Yarzou/porte-magique/docs/notice/img/e-accouplement.png

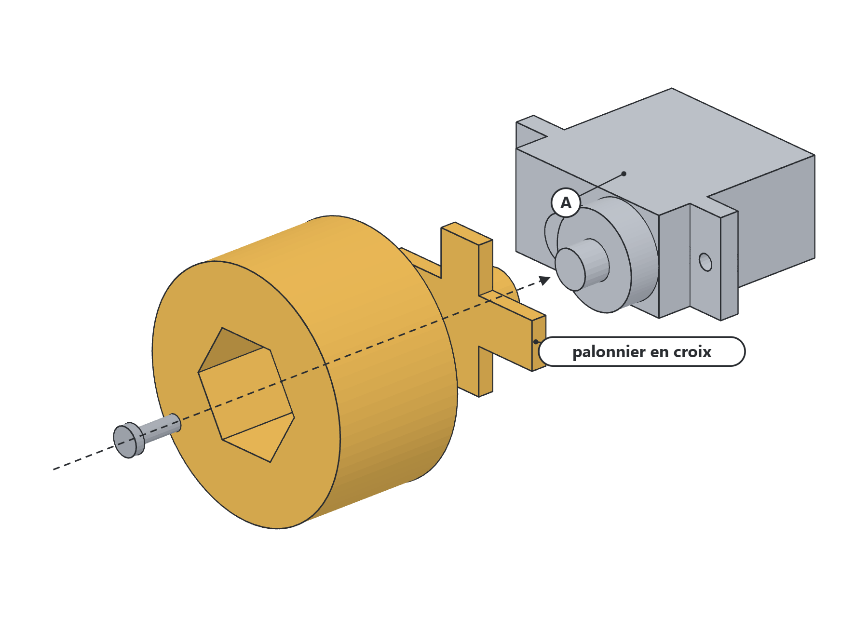
docs/notice/img/e-accouplement.png
