Yarzou/porte-magique/docs/notice/img/e-carte.png

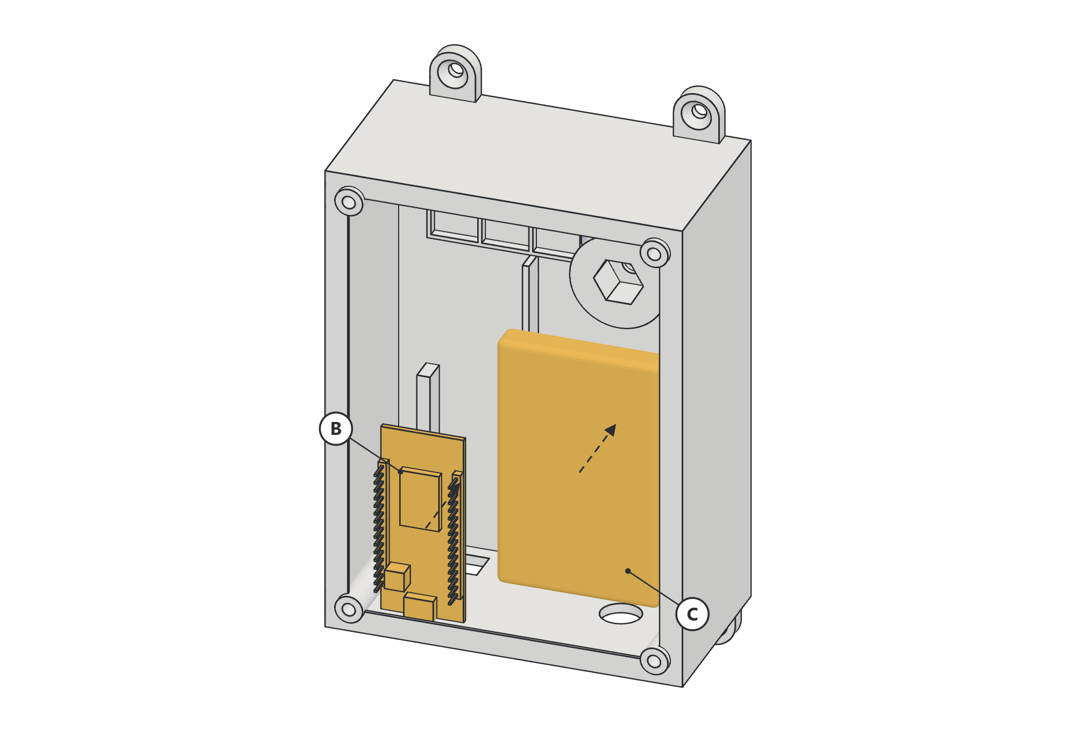
docs/notice/img/e-carte.png
