Yarzou/porte-magique/docs/notice/img/e-fermeture.png

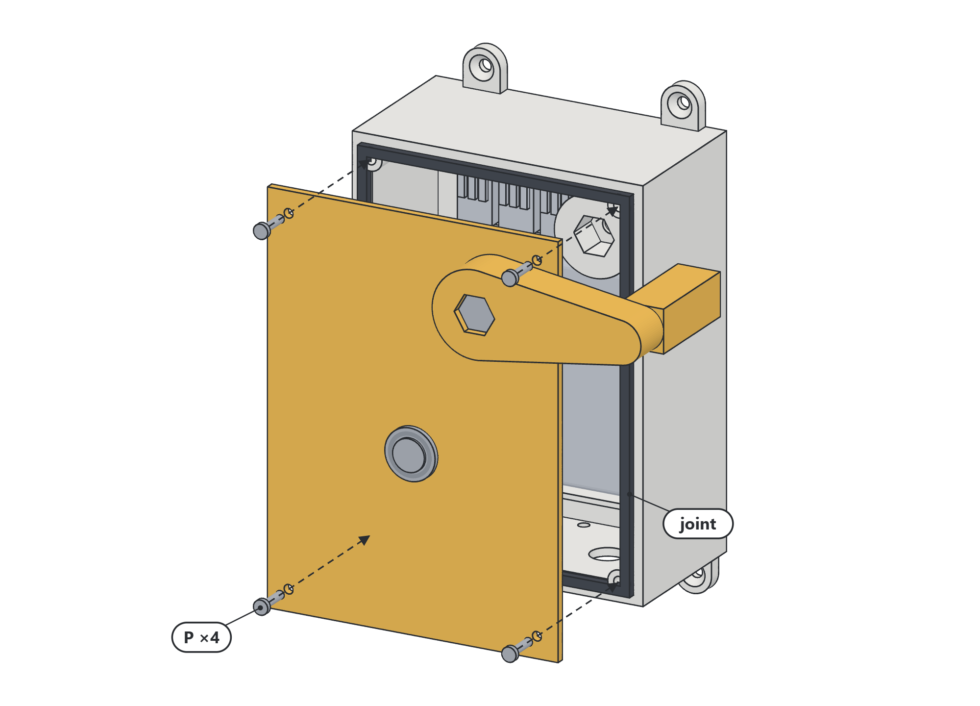
docs/notice/img/e-fermeture.png
