Yarzou/porte-magique/docs/notice/img/e-inserts.png

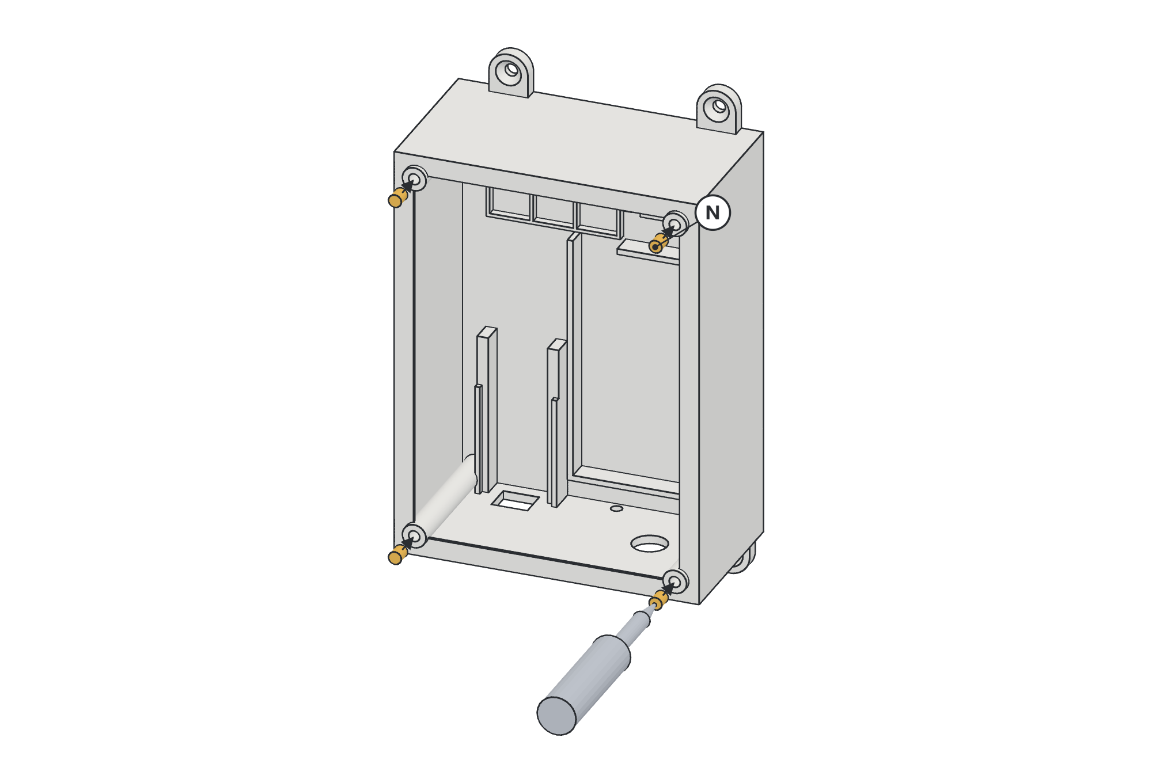
docs/notice/img/e-inserts.png
