Yarzou/porte-magique/docs/notice/img/e-mosfet.png

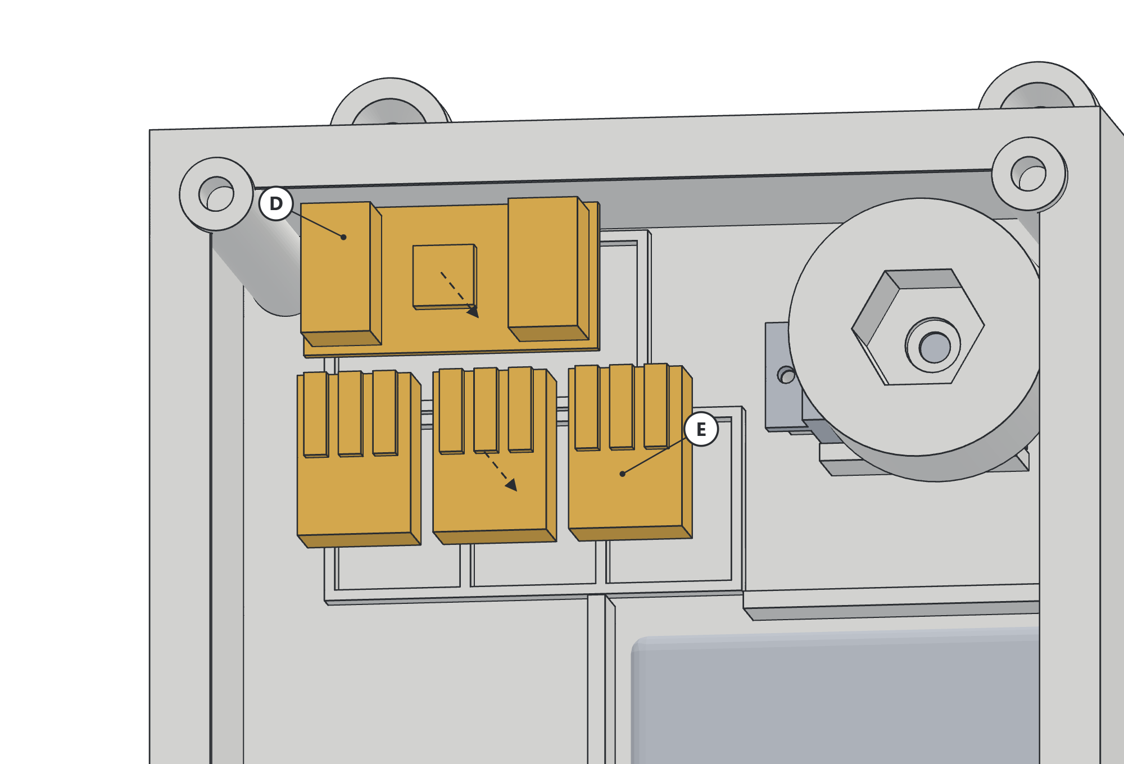
docs/notice/img/e-mosfet.png
