Yarzou/porte-magique/docs/notice/img/e-passerelle.png

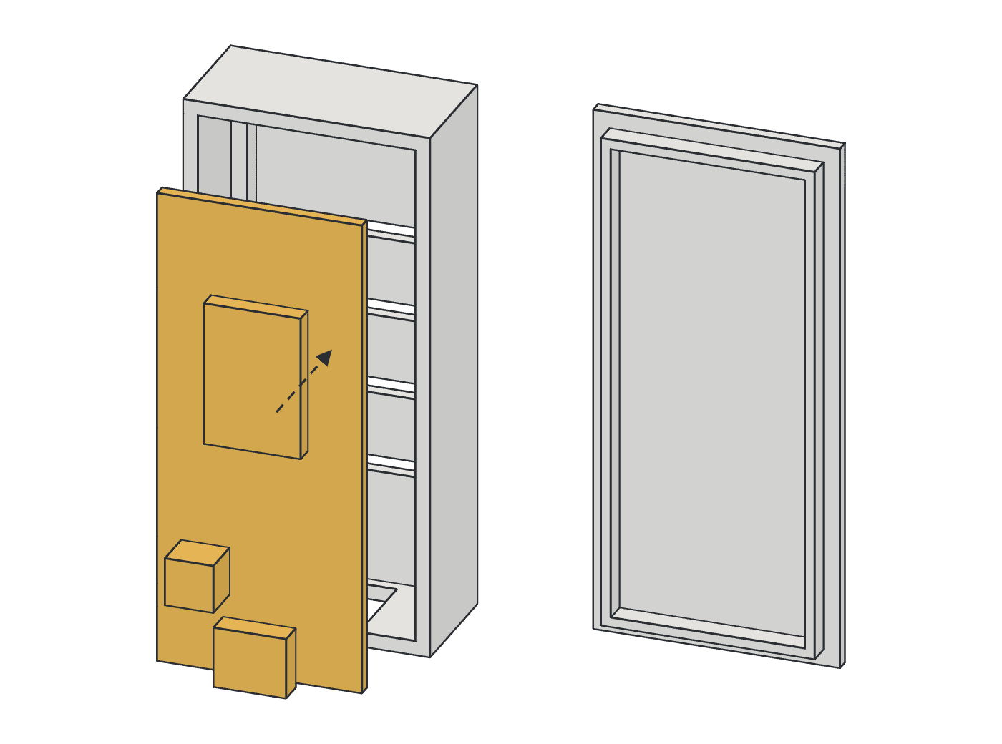
docs/notice/img/e-passerelle.png
