Yarzou/porte-magique/docs/notice/img/e-porte.png

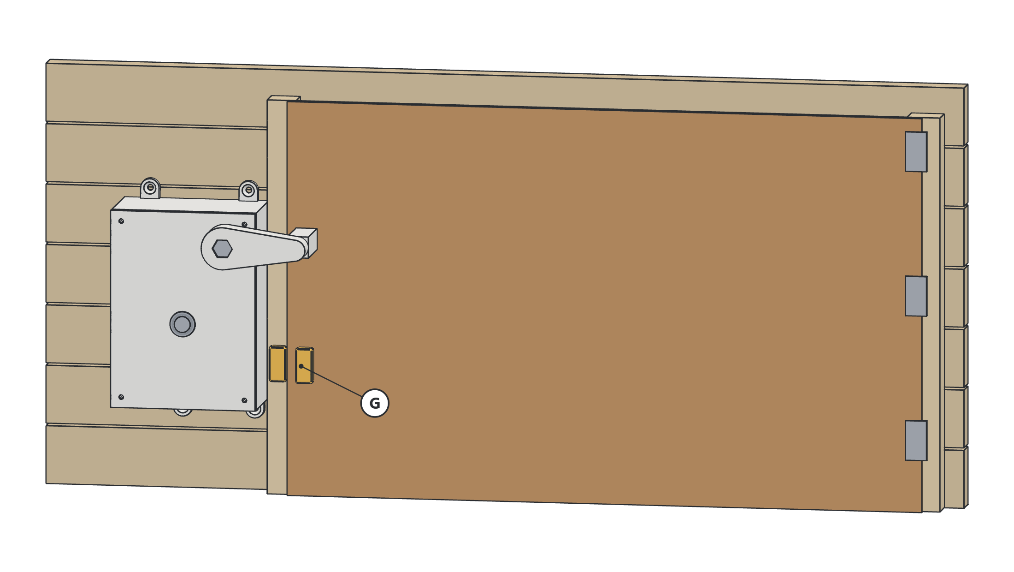
docs/notice/img/e-porte.png
