Yarzou/porte-magique/docs/notice/img/e-presse-etoupe.png

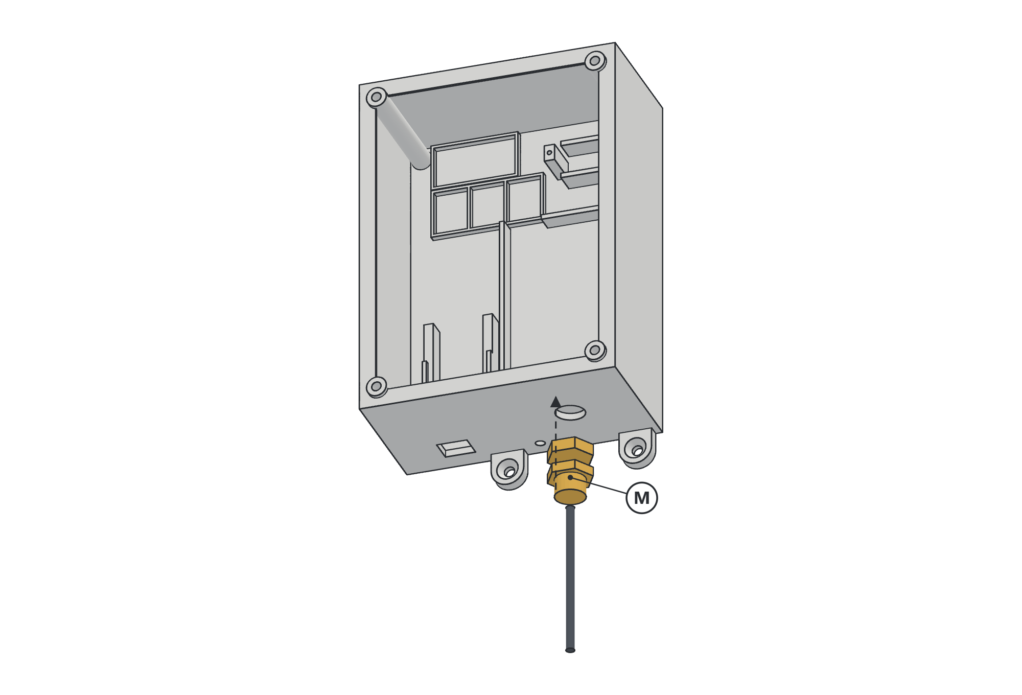
docs/notice/img/e-presse-etoupe.png
