Yarzou/porte-magique/docs/notice/img/e-reglage.png

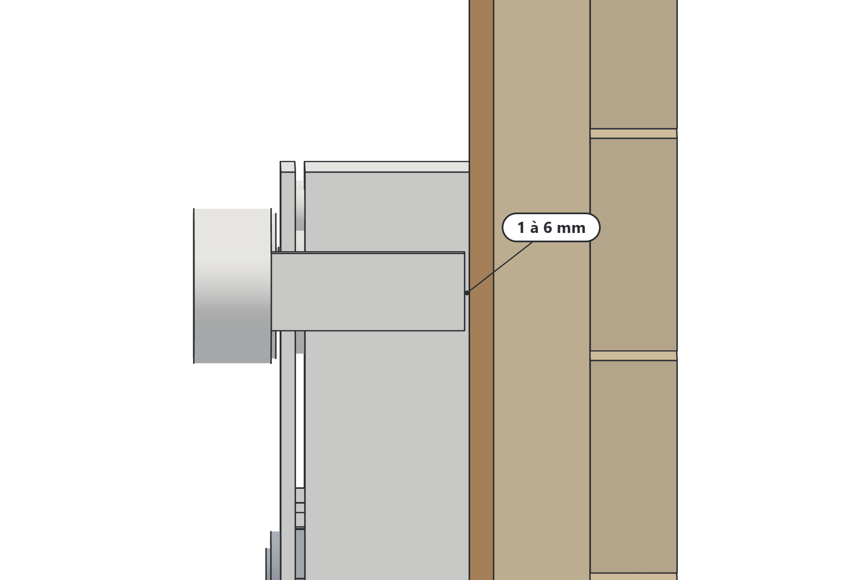
docs/notice/img/e-reglage.png
