Yarzou/porte-magique/docs/notice/img/e-roulement.png

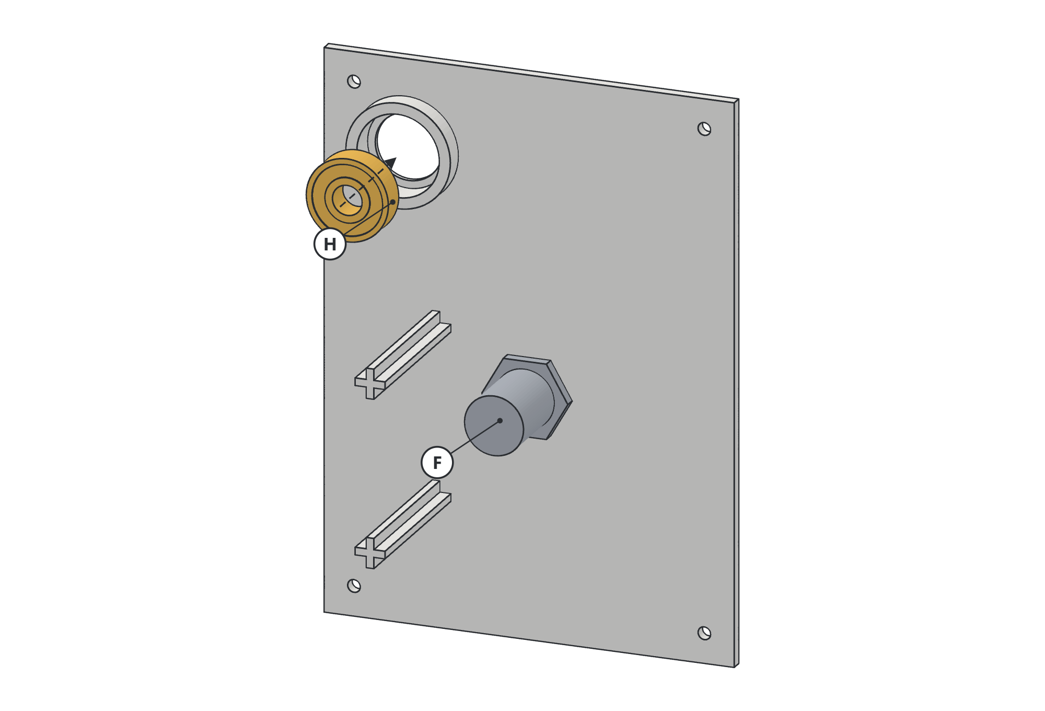
docs/notice/img/e-roulement.png
