Yarzou/porte-magique/docs/notice/img/e-servo.png

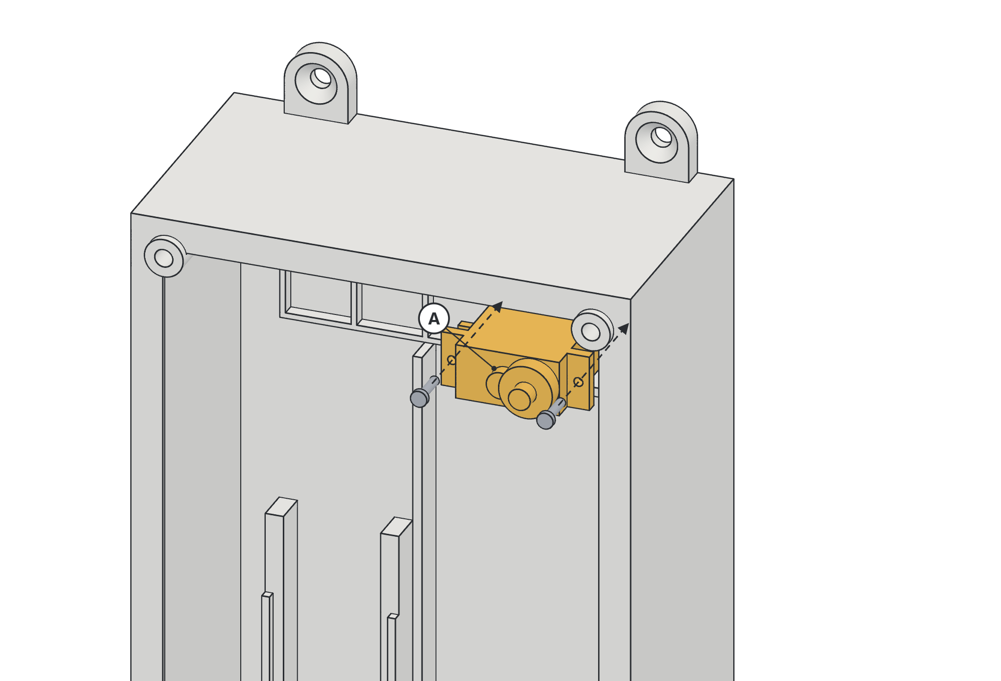
docs/notice/img/e-servo.png
