Yarzou/porte-magique/docs/notice/img/e-taquet.png

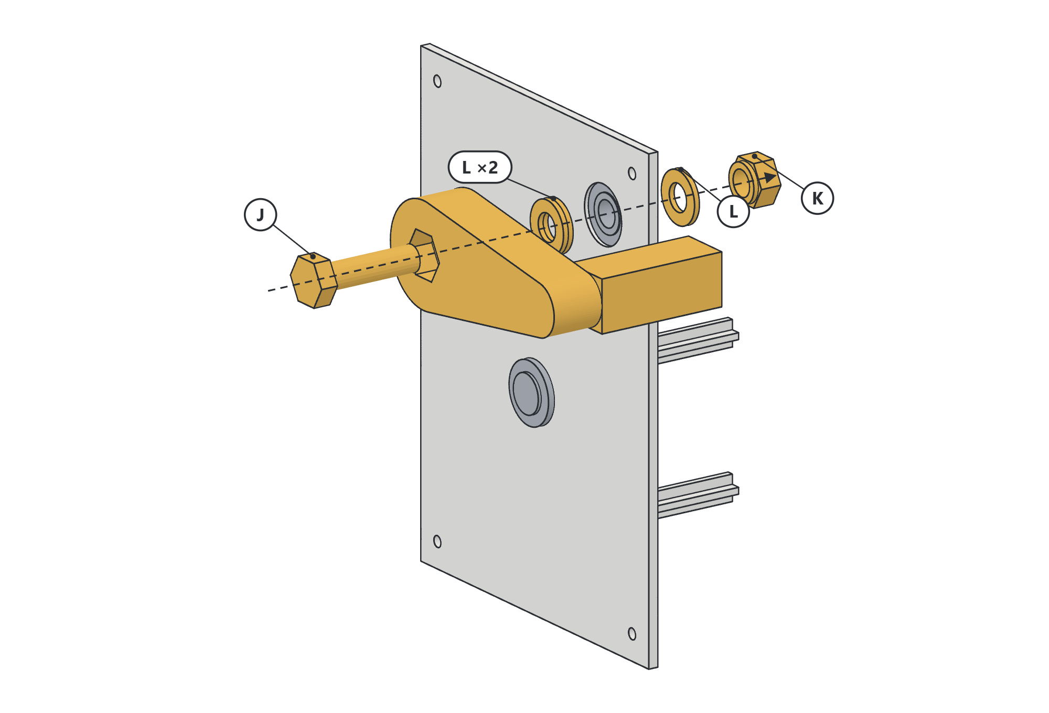
docs/notice/img/e-taquet.png
