Yarzou/porte-magique/docs/notice/img/inv-A.png

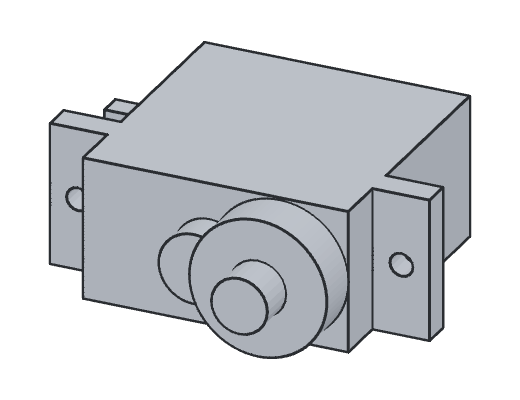
docs/notice/img/inv-A.png
