Yarzou/porte-magique/docs/notice/img/inv-B.png

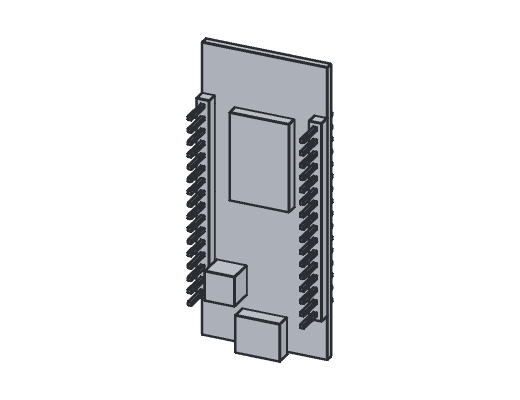
docs/notice/img/inv-B.png
