Yarzou/porte-magique/docs/notice/img/inv-C.png

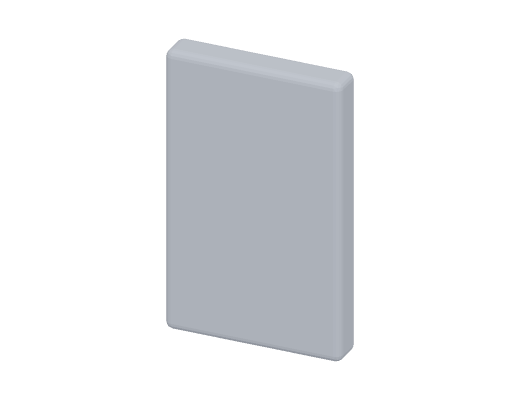
docs/notice/img/inv-C.png
