Yarzou/porte-magique/docs/notice/img/inv-D.png

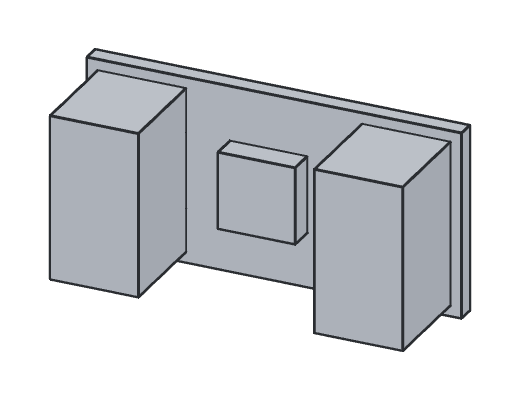
docs/notice/img/inv-D.png
