Yarzou/porte-magique/docs/notice/img/inv-F.png

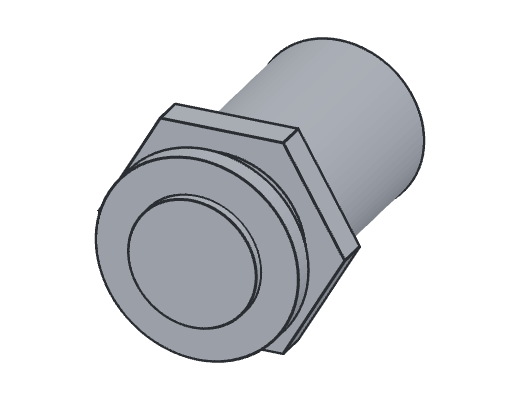
docs/notice/img/inv-F.png
