Yarzou/porte-magique/docs/notice/img/inv-H.png

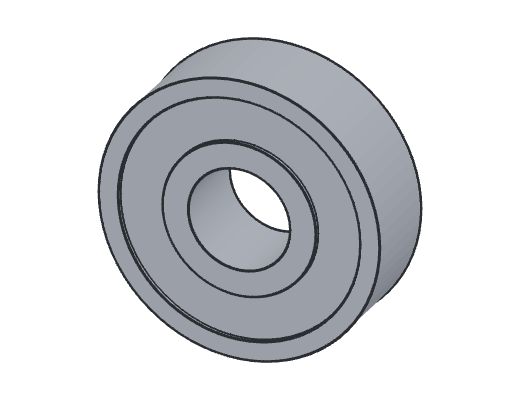
docs/notice/img/inv-H.png
