Yarzou/porte-magique/docs/notice/img/inv-J.png

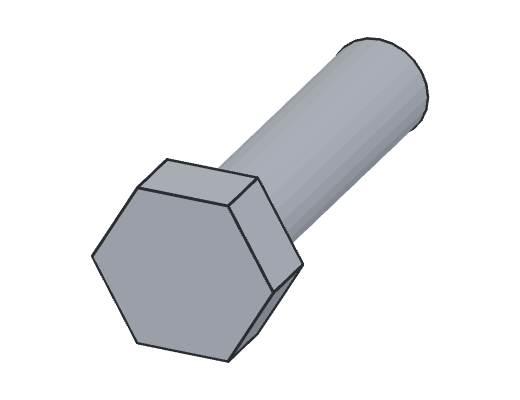
docs/notice/img/inv-J.png
