Yarzou/porte-magique/docs/notice/img/inv-K.png

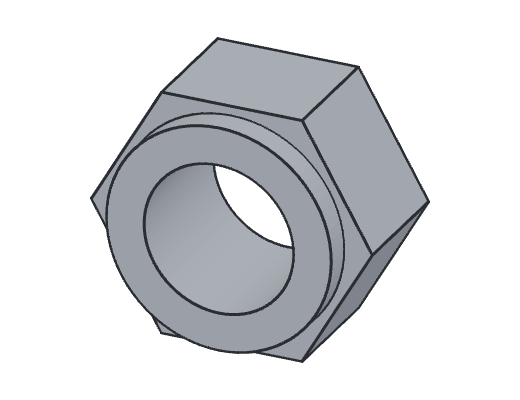
docs/notice/img/inv-K.png
