Yarzou/porte-magique/docs/notice/img/inv-L.png

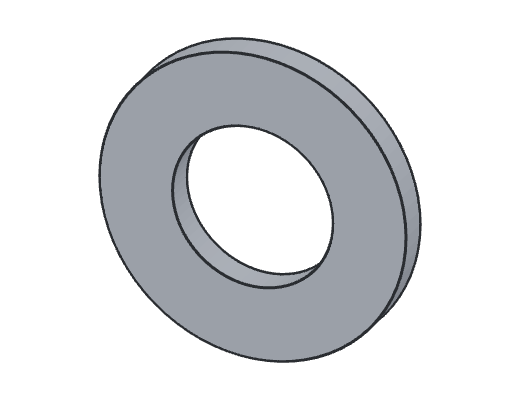
docs/notice/img/inv-L.png
