Yarzou/porte-magique/docs/notice/img/inv-M.png

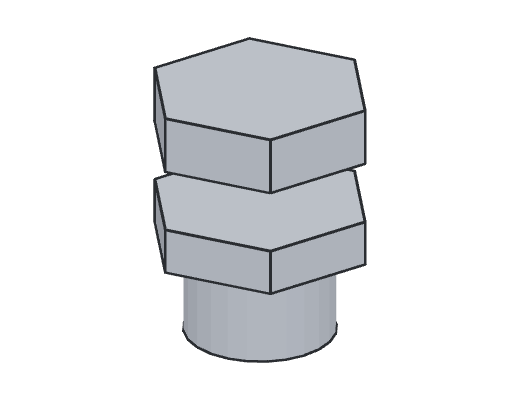
docs/notice/img/inv-M.png
