Yarzou/porte-magique/docs/notice/img/inv-N.png

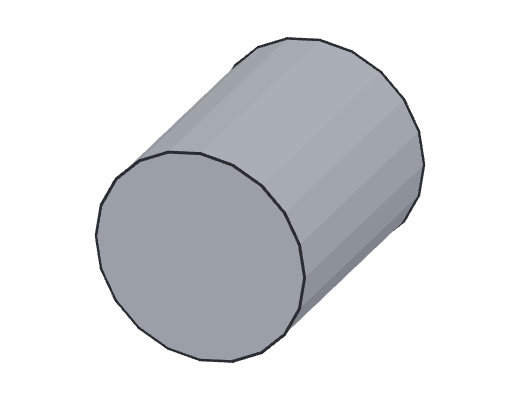
docs/notice/img/inv-N.png
