Yarzou/porte-magique/docs/notice/img/inv-Q.png

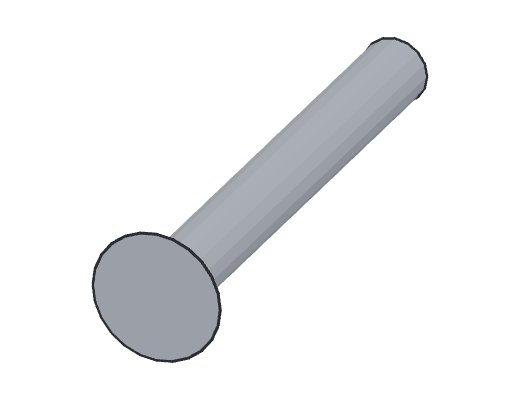
docs/notice/img/inv-Q.png
