Yarzou/porte-magique/docs/notice/img/piece-accouplement.png

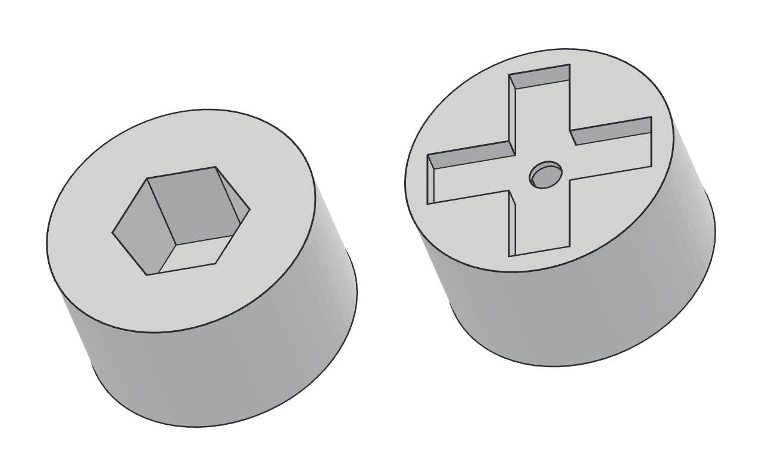
docs/notice/img/piece-accouplement.png
