Yarzou/porte-magique/docs/notice/img/piece-bouchon.png

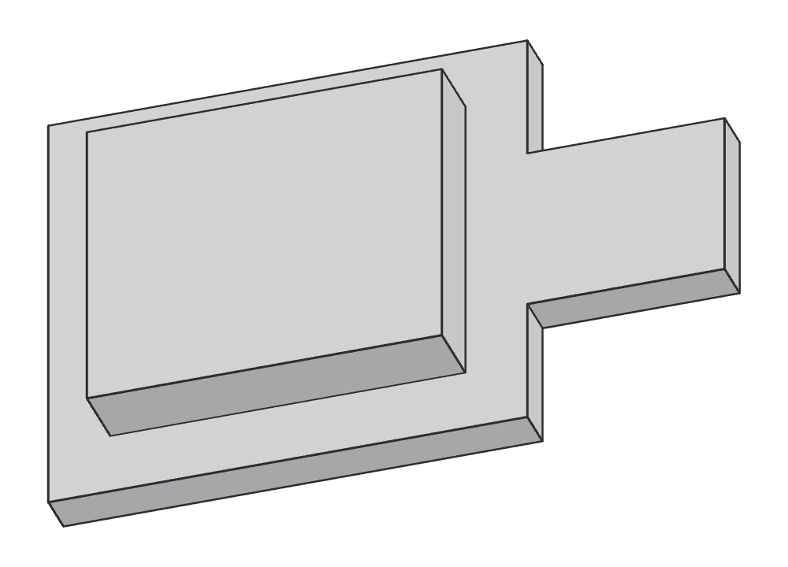
docs/notice/img/piece-bouchon.png
