Yarzou/porte-magique/docs/notice/img/piece-facade.png

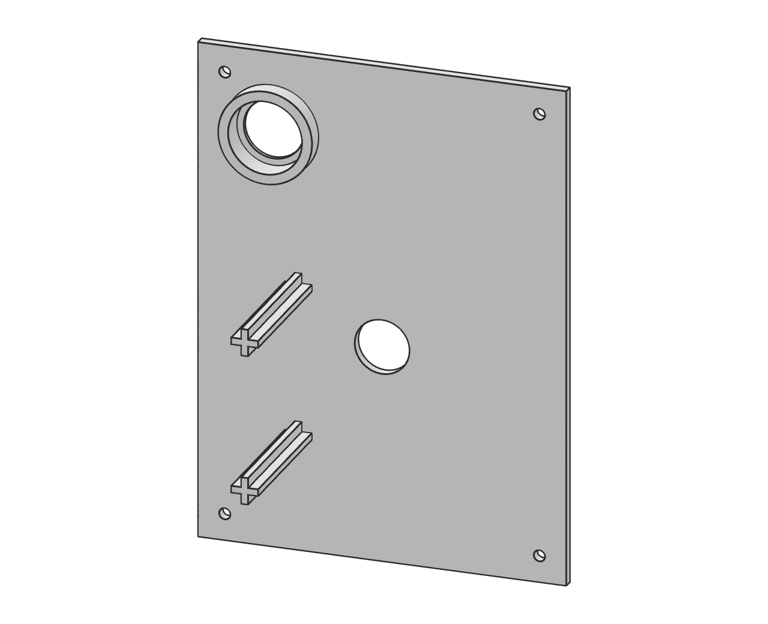
docs/notice/img/piece-facade.png
