Yarzou/porte-magique/docs/notice/img/piece-fond.png

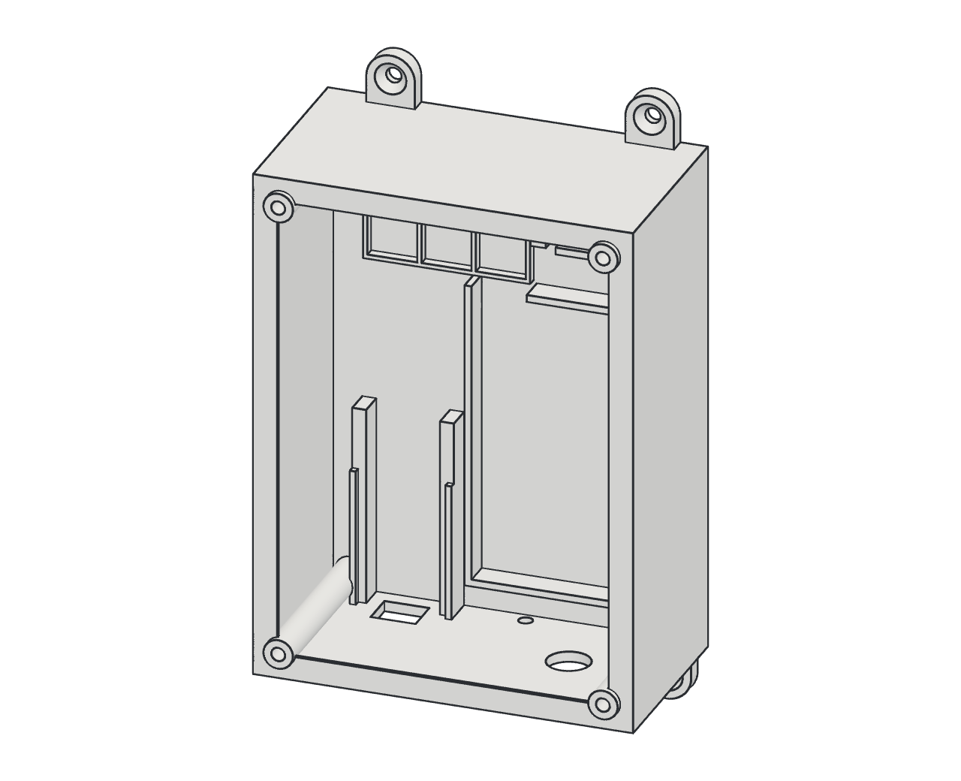
docs/notice/img/piece-fond.png
