Yarzou/porte-magique/docs/notice/img/piece-passerelle.png

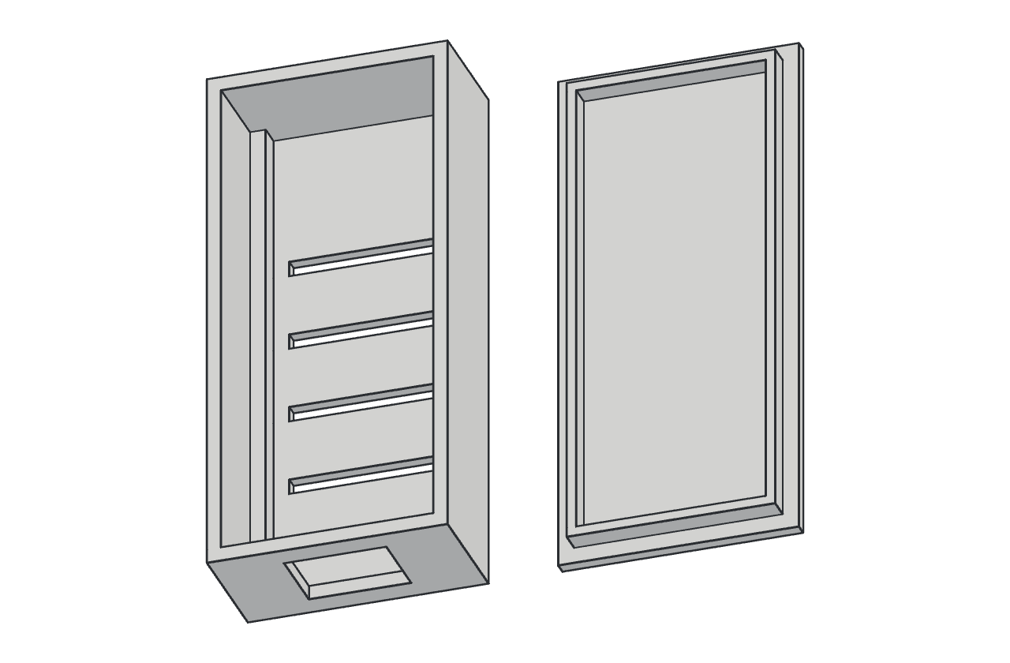
docs/notice/img/piece-passerelle.png
