Yarzou/porte-magique/docs/notice/img/piece-taquet.png

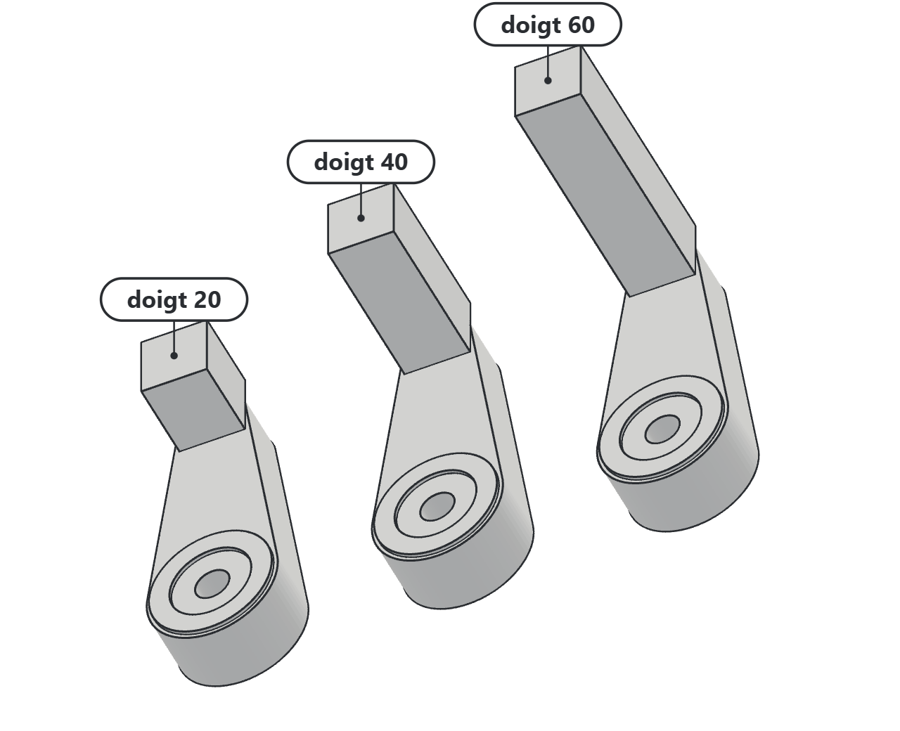
docs/notice/img/piece-taquet.png
