Yarzou/porte-magique/impression/taquet-doigt-45.stl

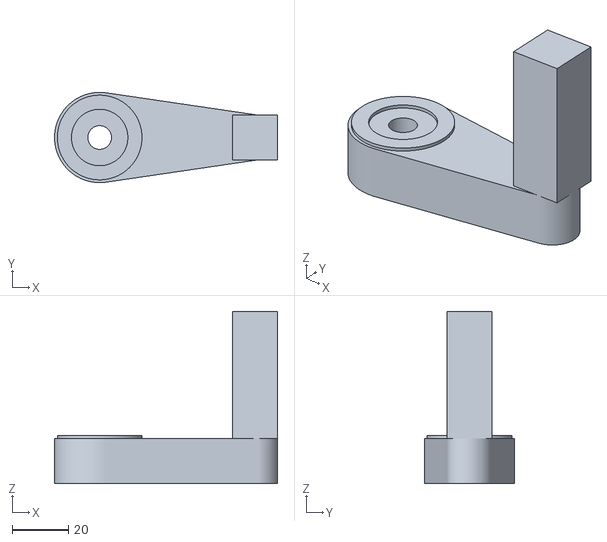
[picture p35: CAD file, 2026-10-15]
impression/taquet-doigt-45.stl
79.0 x 32.0 x 61.0
