Yarzou/porte-magique/impression/taquet-doigt-25.stl

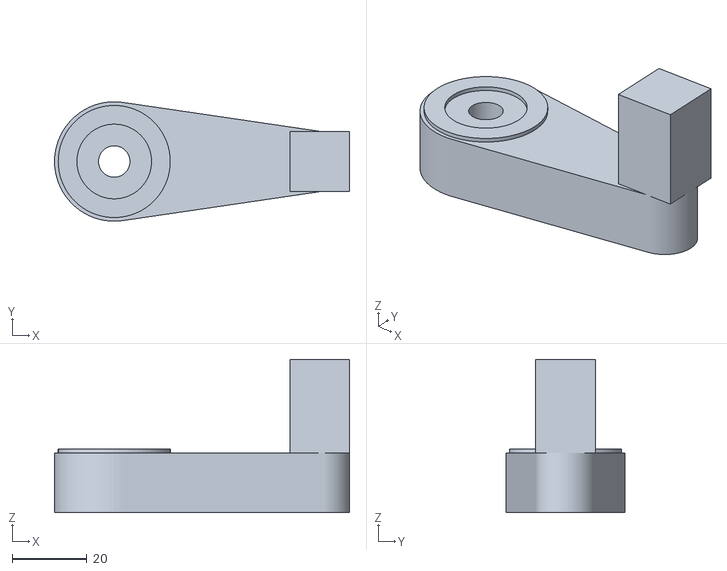
[picture p36: CAD file, 2026-10-15]
impression/taquet-doigt-25.stl
79.0 x 32.0 x 41.0
