Yarzou/porte-magique/impression/boitier-facade-droite.stl

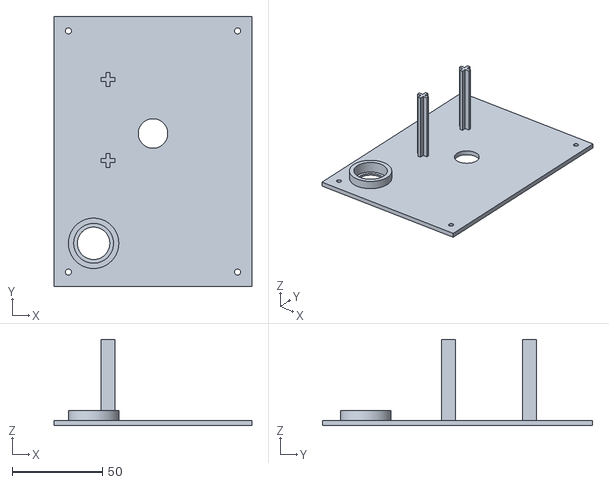
[picture p37: CAD file, 2026-10-15]
impression/boitier-facade-droite.stl
110.0 x 150.0 x 48.0
