Yarzou/porte-magique/impression/boitier-fond-droite.stl

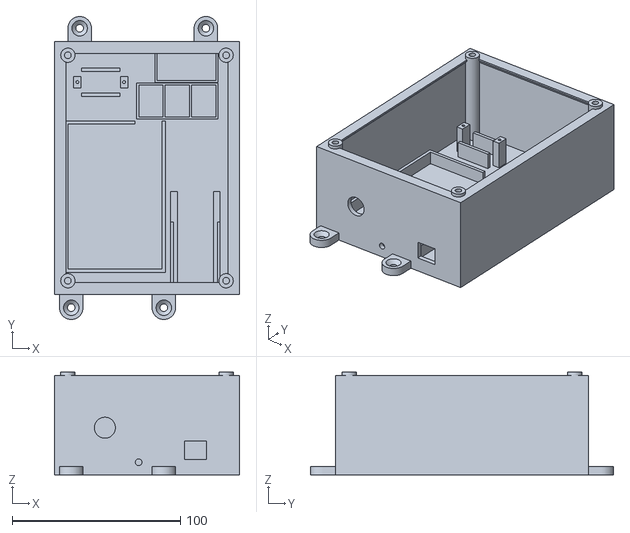
[picture p38: CAD file, 2026-10-15]
impression/boitier-fond-droite.stl
110.0 x 180.0 x 61.0
