Yarzou/porte-magique/impression/taquet-doigt-55.stl

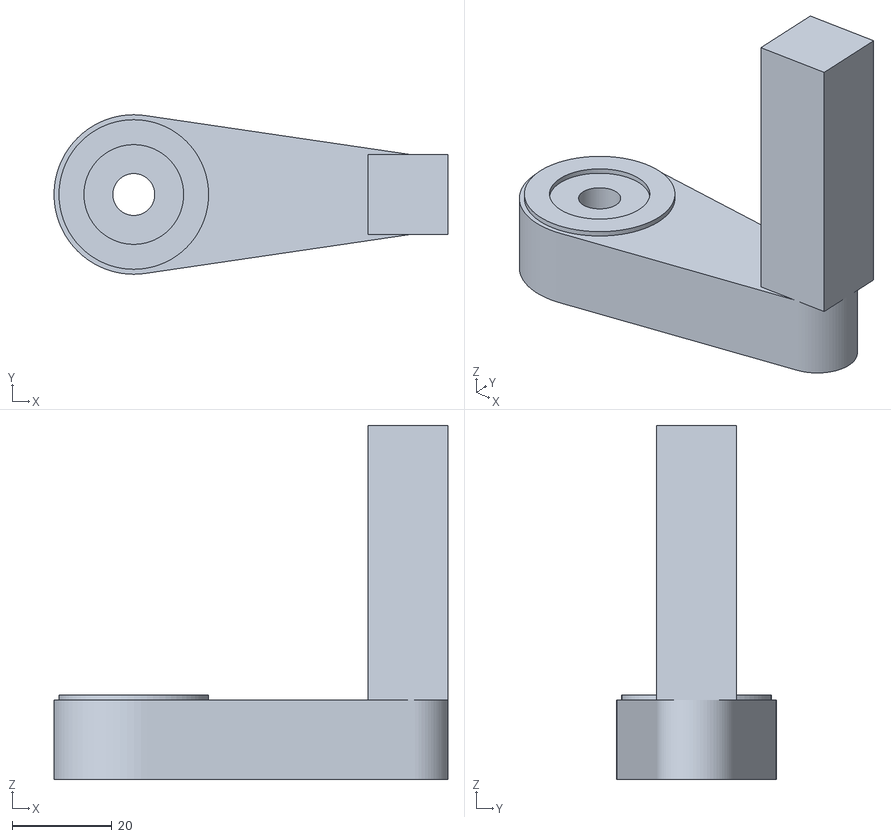
[picture p39: CAD file, 2026-10-15]
impression/taquet-doigt-55.stl
79.0 x 32.0 x 71.0
