Yarzou/porte-magique/impression/taquet-doigt-35.stl

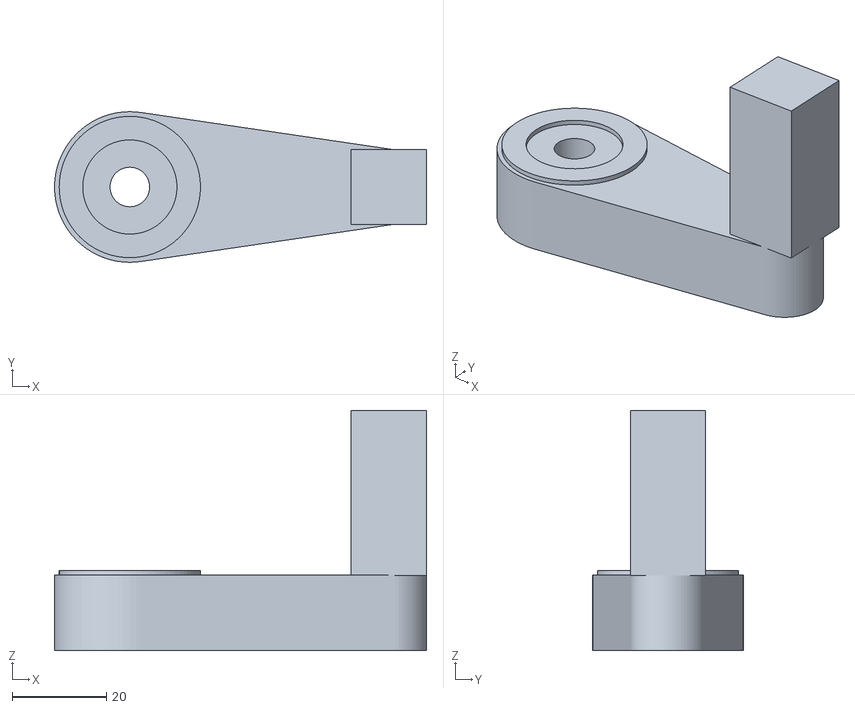
[picture p40: CAD file, 2026-10-15]
impression/taquet-doigt-35.stl
79.0 x 32.0 x 51.0
