Yarzou/porte-magique/impression/accouplement.stl

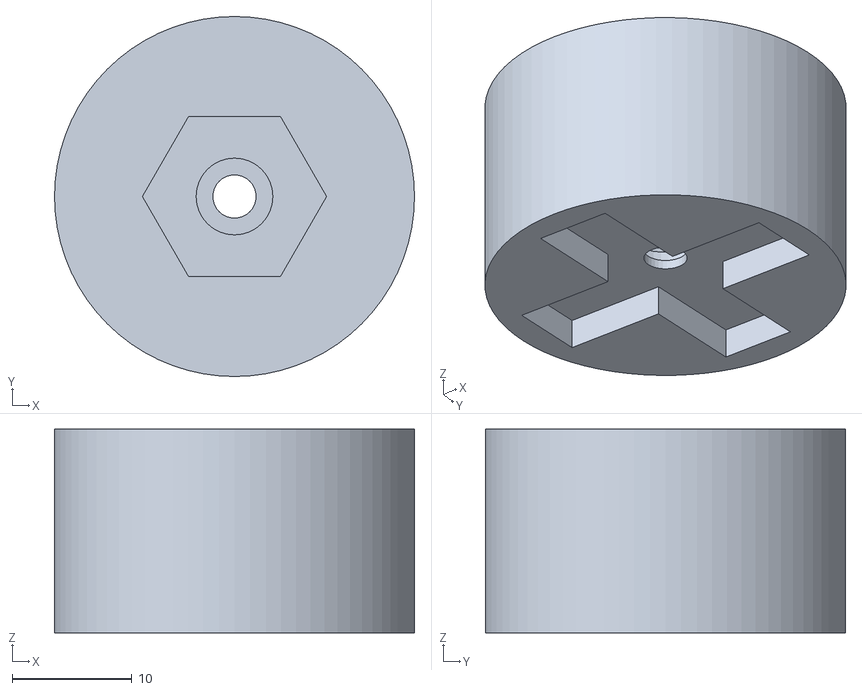
[picture p41: CAD file, 2026-10-15]
impression/accouplement.stl
30.0 x 30.0 x 17.0
