Yarzou/porte-magique/impression/taquet-doigt-20.stl

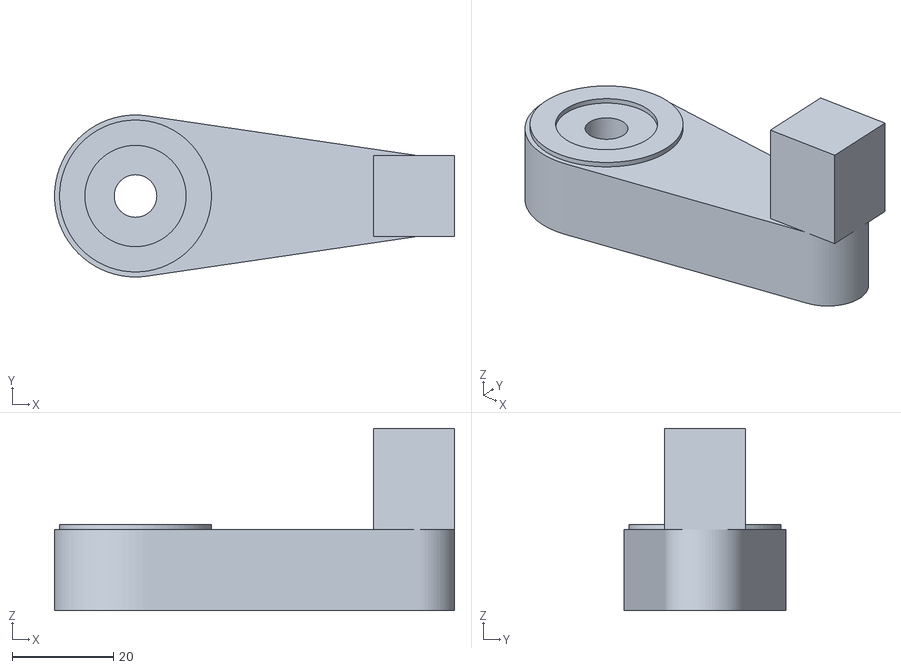
[picture p42: CAD file, 2026-10-15]
impression/taquet-doigt-20.stl
79.0 x 32.0 x 36.0
