Yarzou/porte-magique/impression/passerelle-fond.stl

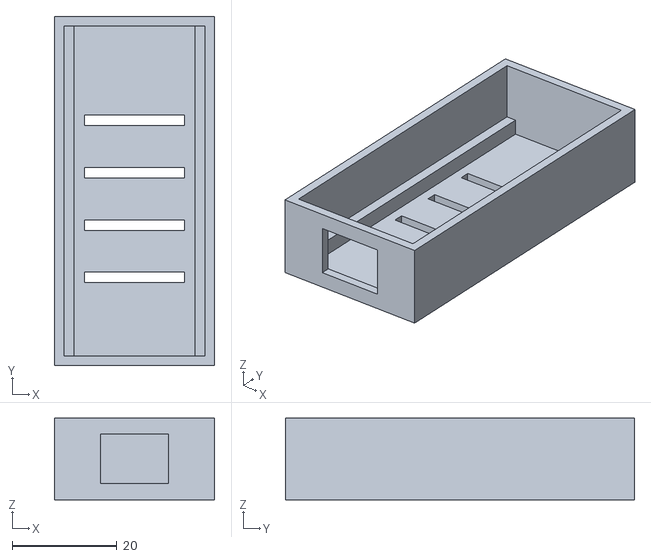
[picture p43: CAD file, 2026-10-15]
impression/passerelle-fond.stl
30.6 x 66.6 x 15.6
