Yarzou/porte-magique/impression/taquet-doigt-60.stl

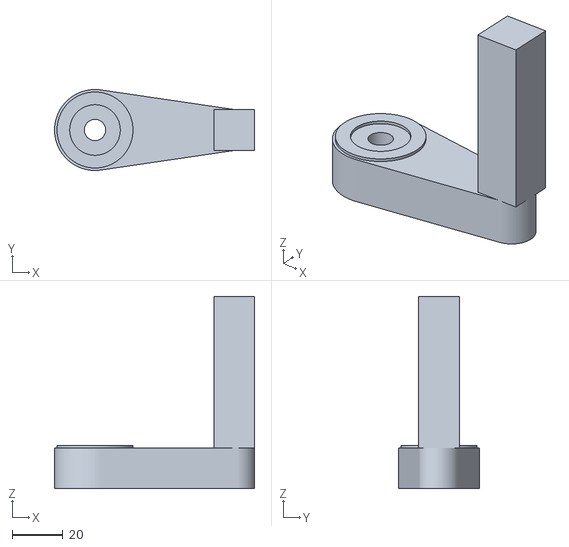
[picture p44: CAD file, 2026-10-15]
impression/taquet-doigt-60.stl
79.0 x 32.0 x 76.0
