Yarzou/porte-magique/impression/taquet-doigt-50.stl

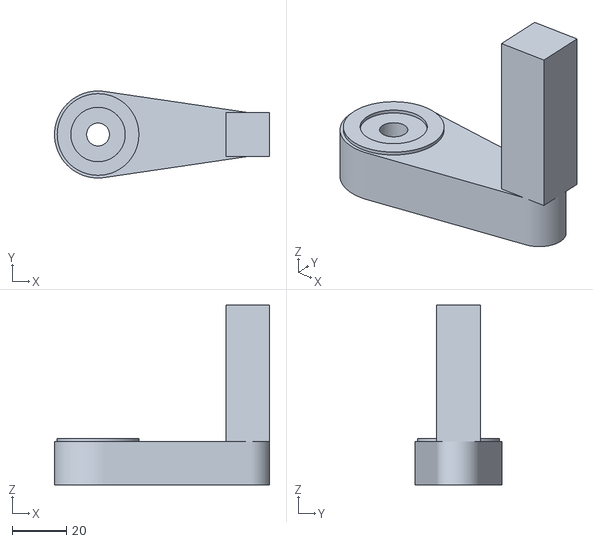
[picture p45: CAD file, 2026-10-15]
impression/taquet-doigt-50.stl
79.0 x 32.0 x 66.0
