Yarzou/porte-magique/impression/taquet-doigt-40.stl

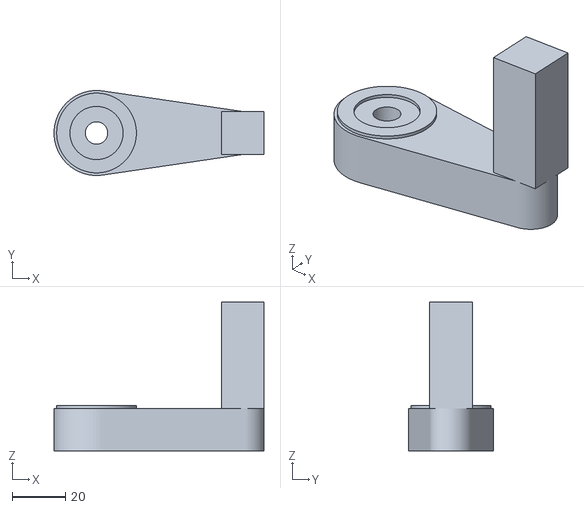
[picture p46: CAD file, 2026-10-15]
impression/taquet-doigt-40.stl
79.0 x 32.0 x 56.0
