Yarzou/porte-magique/impression/taquet-doigt-30.stl

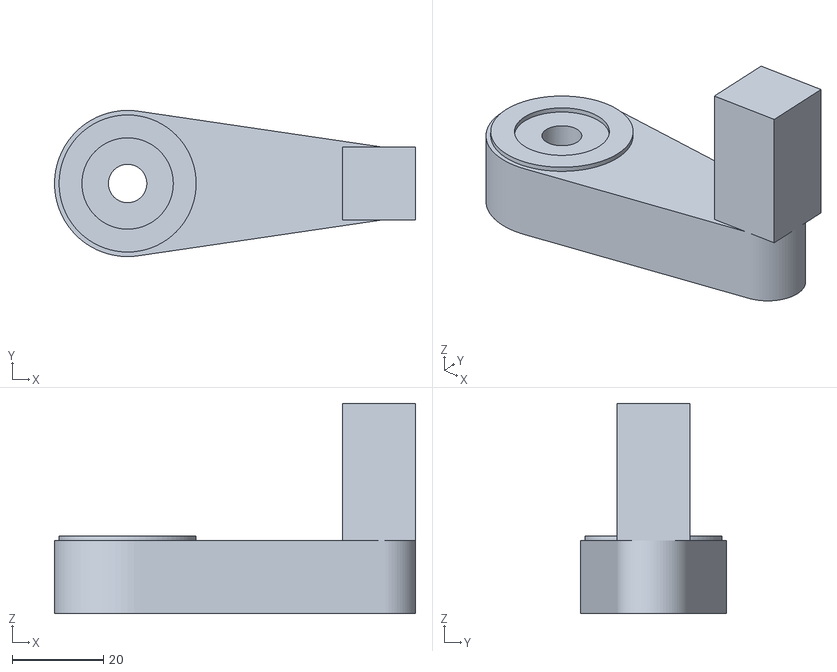
[picture p47: CAD file, 2026-10-15]
impression/taquet-doigt-30.stl
79.0 x 32.0 x 46.0
