Yarzou/porte-magique/impression/passerelle-couvercle.stl

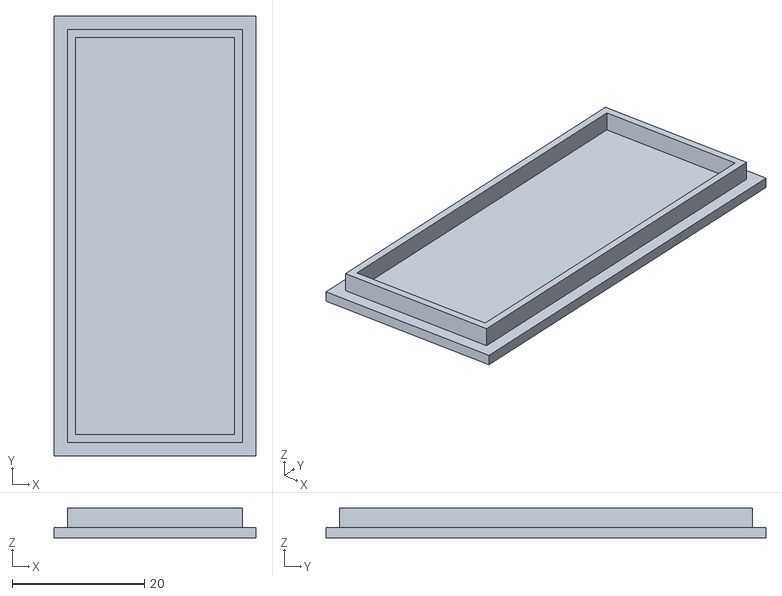
[picture p48: CAD file, 2026-10-15]
impression/passerelle-couvercle.stl
30.6 x 66.6 x 4.50
