Yarzou/porte-magique/impression/bouchon-usb.stl

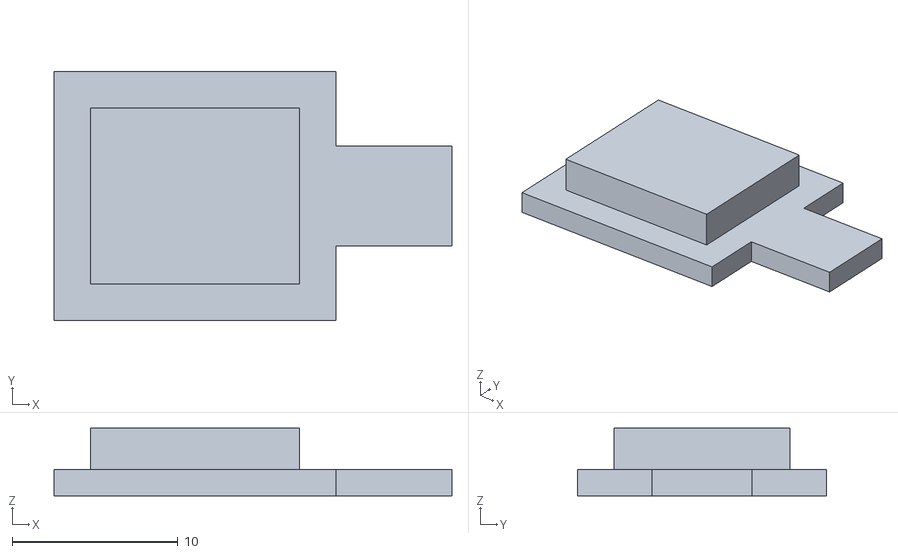
[picture p49: CAD file, 2026-10-15]
impression/bouchon-usb.stl
24.0 x 15.0 x 4.10
