Yarzou/porte-magique/(list of files, cad)

Other CAD files:
impression/boitier-fond-gauche.stl
impression/boitier-facade-gauche.stl
