Yarzou/porte-magique/(commit log)

2026-10-15 docs: matériel et liste d'achat de la porte magique
2026-10-15 feat: pièces à imprimer du boîtier et du taquet (sources JSCAD et STL)
2026-10-15 docs: liste d'achat sans soudure fine et dessins de la notice
2026-10-15 docs: notice de montage pas à pas
2026-10-15 chore: les rendus effacent leurs pages temporaires
2026-10-15 docs: liste d'achat, sachets de silice et total
2026-10-15 docs: image du boîtier dans le README et la liste d'achat
2026-10-15 docs: liste d'achat réduite à l'essentiel
    Ne restent que les pièces qui ne s'impriment pas. Retirés : charnière à
    ressort, loqueteau, sangle velcro, patins, silice, filament, étain, flux
    et outils (déjà à la maison).
    - les appuis de la façade tiennent seuls la batterie (plus de fentes de
    sangle dans le fond)
    - taquets tous les 5 mm, à la place des patins au bout du doigt
    - notice, dessins, STL et PDF régénérés
2026-10-15 feat: appli de la porte magique (Next.js, Supabase, passkeys, notifications)
2026-10-15 docs: références Amazon dans la liste d'achat
    Chaque ligne pointe vers l'offre retenue, avec son prix. Seules les
    cartes FireBeetle 2 ESP32-C6 restent hors Amazon.
    - contact de porte MC-38 à deux fils, en applique
    - bouton à voyant vert seul : ses deux fils vont sur D6 et 19/SDA,
    voyant éteint quand la porte est fermée
    - une paire de fils JST-PH remplace la rallonge coupée en deux
    - dessins du voyant et PDF régénérés
2026-10-16 fix: PDF et STL passent par la feuille de partage (on restait bloqué dans l'appli iPhone)
2026-10-16 feat: lire les PDF dans l'appli (pdf.js), avec fermer, zoom et partager
2026-10-16 docs: liste d'achat moins chère, en trois commandes
    La commande complète passe d'environ 235 € à environ 105 € (40 € par
    porte, passerelle comprise).
    - cartes FireBeetle chez Gotronic : 7,50 € pièce, port offert à 4
    - un seul panier AliExpress pour l'électronique et la petite mécanique,
    avec la variante à prendre dans « À vérifier »
    - Brico Dépôt pour les vraies WAGO, les vis à bois et l'adhésif 3M
    - notice : fils Dupont mâle-femelle seuls, joint de 3 mm d'épaisseur
    - appli : le bouton de chaque article affiche le nom de la boutique
